SpawnageLoong/cde4301-final-report/README.md

# ASI-404: Galassia-5 Radiation Monitoring Payload Final Report

This is the final report for the Galassia-5 Radiation Monitoring Payload.

This website was built using the [Just the Docs](https://just-the-docs.com/) Jekyll theme. The theme is designed to be a simple and clean documentation theme for Jekyll.
