SpawnageLoong/cde4301-final-report/pages/4_references.md

---
title: "Appendix A: References"
nav_order: 4
permalink: /references/
---

# References

### Baraniuk, C. (2022, October 12). The computer errors from outer space. BBC. [Link](https://www.bbc.com/future/article/20221011-how-space-weather-causes-computer-errors)

### Seidleck, C. M., LaBel, K. A., Moran, A. K., Gates, M. M., Barth, J. M., Stassinopoulos, E. G., & Gruner, T. D. (n.d.). Single Event Effect Flight Data Analysis of Multiple NASA Spacecraft and Experiments; Implications to Spacecraft Electrical Designs. [Link](https://nepp.nasa.gov/docuploads/F077ADF5-6491-45DA-AE3904DA8D0C36A1/chris.pdf)

### Noeldeke, C., Boettcher, M., Mohr, U., Gaisser, S., Rua, M. A., Eickhoff, J., Leslie, M., Von Thun, M., Klinkner, S., & Varatharajoo, R. (2021). Single event upset investigations on the “Flying Laptop” satellite mission. Advances in Space Research, 67(6), 2000–2009. [Link](https://www.sciencedirect.com/science/article/pii/S0273117720309054)

### Poivey, C., Barth, J. L., LaBel, K. A., Gee, G., & Safren, H. (n.d.). In-Flight Observations of Long-Term Single- Event Effect (SEE) Performance on Orbview-2 Solid State Recorders (SSR). [Link](https://radhome.gsfc.nasa.gov/radhome/papers/nsrec03_w16.pdf)

### Olsen, W., Wood, B., & Dennison, J. (n.d.). Microcontroller Survivability in Space Conditions. [Link](https://digitalcommons.usu.edu/cgi/viewcontent.cgi?article=1406&context=researchweek)

### Matthews, M. (2021). Using bit flips as a source of randomness in cubeSat communication encryption. Acta Astronautica, 179, 546–549. [Link](https://www.sciencedirect.com/science/article/pii/S0094576520307128)

### Awati, R., & Sheldon, R. (2024, October 31). What is SRAM (static random access memory)? WhatIs. [Link](https://www.techtarget.com/whatis/definition/SRAM-static-random-access-memory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,retain%20the%20data%20in%20SRAM)

### bitsmashed. (2009, October 20). Random number generating Geiger counter. Sparkfun. Retrieved August 22, 2024, from [Link](https://www.sparkfun.com/tutorials/132)

### Gorkovenko, A. V., Sawczyn, S., Bulgakova, N. V., Jasczur-Nowicki, J., Mishchenko, V. S., & Kostyukov, A. I. (2012). Muscle agonist–antagonist interactions in an experimental joint model. Experimental Brain Research, 222(4), 399–414. [Link](https://doi.org/10.1007/s00221-012-3227-0)

### Hansen, D. L., Hillman, R., Meraz, F., Montoya, J., & Williamson, G. (n.d.). Architectural consequences of radiation performance in a flash NAND device. [Link](https://www.ddc-web.com/resources/assets/images/Articles/2017/Architectural_Consequences_of_Radiation_Performance_in_a_Flash_NAND_Device.pdf)

### Kay, M., Gadlage, M., Duncan, A., Ingalls, D., Roach, A., & NSWC Crane. (2017). Flash memory in extreme environments. In Flash Memory Summit. [Link](https://files.futurememorystorage.com/proceedings/2017/20170808_S102B_Kay.pdf)

### LND. Inc. (n.d.). 712 End Window-Alpha-Beta-Gamma Detector. LND | Nuclear Radiation Detectors. Retrieved August 13, 2024, from [Link](https://www.lndinc.com/products/geiger-mueller-tubes/712/)

### Matsusada Precision Inc. (2024). Geiger counter (Geiger-Müller tube). Matsusada Precision. Retrieved September 10, 2024, from [Link](https://www.matsusada.com/application/ps/geiger_counter/)

### NASA Science Editorial Team. (2024, September 17). Innovative Instrument Reveals Hidden Features Deep Inside the Van Allen Radiation Belts. NASA. Retrieved August 28, 2024, from [Link](https://science.nasa.gov/science-research/science-enabling-technology/technology-highlights/innovative-instrument-reveals-hidden-features-deep-inside-the-van-allen-r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)

### National Aeronautics and Space Administration. (n.d.). Outgassing Data Introduction. NASA. Retrieved October 19, 2024, from [Link](https://outgassing.nasa.gov/outgassing-data-table)

### National Aeronautics and Space Administration. (2001, September 20). NASA Parts Selection List (NPSL) - Zinc plating prohibition. NASA. Retrieved October 23, 2024, from[Link](https://nepp.nasa.gov/npsl/prohibited/zinc_prohibition.htm)

### Nuclear Power. (2024). Geiger Counter vs Ionization Chamber. Retrieved August 23, 2024, from[Link](https://www.nuclear-power.com/nuclear-engineering/radiation-detection/gaseous-ionization-detector/geiger-counter-vs-ionization-chamber/)

### Ogasawara, K., Livi, S. A., Allegrini, F., Broiles, T. W., Dayeh, M. A., Desai, M. I., Ebert, R. W., Llera, K., Vines, S. K., & McComas, D. J. (2016). Next‐generation solid‐state detectors for charged particle spectroscopy. Journal of Geophysical Research Space Physics, 121(7), 6075–6091.[Link](https://doi.org/10.1002/2016ja022559)

### S.E. International, Inc. (2019, February 14). About Radiation Detectors - Advantages & Disadvantages. Retrieved September 23, 2024, from[Link](https://seintl.com/articles/about-radiation-detectors-advantages-amp-disadvantages)

### Shah, G. (2024). Semiconductor Radiation Detector. VEDANTU. Retrieved September 23, 2024, from[Link](https://www.vedantu.com/physics/solid-state-detector)

### USC Environmental Health & Safety. (n.d.). Radiation instrumentation – USC Environmental Health & Safety. USC. Retrieved August 23, 2024, from[Link](https://ehs.usc.edu/research/rad/rad-instruments/#:~:text=Ion%20chambers%20are%20similar%20to,counting%20the%20number%20of%20pulses)

### XP Power. (2024a). AH Series Power Product Range | XP Power. Retrieved October 2, 2024, from[Link](https://www.xppower.com/product/AH-Series)

### XP Power. (2024b). DC-HVDC Converter Q Series. Retrieved October 3, 2024, from[Link](https://www.xppower.com/portals/0/pdfs/SF_Q_Series.pdf)

### XP Power. (2024c). CA Series DC-HVDC converter. Retrieved October 2, 2024, from[Link](https://www.xppower.com/portals/0/pdfs/SF_CA_Series.pdf)

### Zero Error Systems. (2022a). Single-Event Effects (SEE) Test Report of ZES100F-QFN32SP Latchup Detection and Protection (LDAP).

### Zero Error Systems. (2022b). Heavy-Ion Single-Event Effect (SEE) Test report of the ZES400-F/S-QFN28SP Quad-Channel Voter.

### Zero Error Systems. (2023a). Total Ionizing Dose (TID) Test Report of ZES100F-QFN32SP Latchup Detection and Protection (LDAP).

### Zero Error Systems. (2023b). Total Ionizing Dose (TID) Test Report of the ZES400 Quad-Channel voter.

### Zero Error Systems. (2024a). Proton Single-Event Effect (SEE) Test Report of ZSOM-M01.

### Zero Error Systems. (2024b). Radiation-Tolerant Microcontroller-Based System-on-Module (ZSOMTM-M01). In DOEEET. Retrieved August 16, 2024, from[Link](https://www.doeeet.com/home/-/catalog/document/MFR_DS_ZSOM_M01_Radiation_Tolerant_Microcontroller_Based_System_on_Module__ZSOMTM_M01__1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)

### Curbell plastics. (n.d.). Peek Plastic Material & properties | high temp, chemical resistance |[Link](https://www.curbellplastics.com/materials/plastics/peek/)

### Ensinger. (n.d.). Radiation resistant plastics.[Link](https://www.ensingerplastics.com/en-us/shapes/plastic-material-selection/radiation-resistant)

### GQ GMC-600 Plus Geiger Counter Radiation Monitor. GQ Electronics LLC True Instruments Solution. (n.d.).[Link](https://www.gqelectronicsllc.com/comersus/store/comersus_viewItem.asp?idProduct=5637)

### Howell, E. (2018, May 11). Van allen radiation belts: Facts & findings. Space.com.[Link](https://www.space.com/33948-van-allen-radiation-belts.html )

### IMS Team. (n.d.). Aluminum radiation shielding in 3D imaging - IMS. Industrial Metal Service.[Link](https://industrialmetalservice.com/metal-university/aluminum-radiation-shielding-in-3d-imaging/ )

### Julien. (n.d.). The Van Allen Belts: Are they dangerous?. Listing of all our blogs.[Link](https://blogs.esa.int/orion/2022/12/10/the-van-allen-belts-are-they-dangerous/ )

### Kelley, R. L., & Jarkey, D. R. (n.d.). CUBESAT material limits for design for demise.[Link](https://ntrs.nasa.gov/api/citations/20140016958/downloads/20140016958.pdf )

### Khozemy, E. E., Salem, E. F., & El-Hag Ali, A. (2022). Radiation shielding and enhanced thermal characteristics of high-density polyethylene reinforced with Al (OH)3/PB2O3 for Radioactive Waste Management. Radiation Physics and Chemistry, 193, 109976. [Link](https://doi.org/10.1016/j.radphyschem.2022.109976)

### NASA. (2024, August 16). What are SmallSats and CubeSats?. NASA. [Link](https://www.nasa.gov/what-are-smallsats-and-CubeSatss/)

### Ojovan, M. I., Lee, W. E., & Kalmykov, S. N. (2019b). An Introduction to Nuclear Waste Immobilisation, 53–55. [Link](https://doi.org/10.1016/c2017-0-03752-7)

### Onaizi, A. M., Amran, M., Tang, W., Betoush, N., Alhassan, M., Rashid, R. S. M., Yasin, M. F., Bayagoob, K. H., & Onaizi, S. A. (2024). Radiation-shielding concrete: A review of materials, performance, and the impact of radiation on concrete properties. Journal of Building Engineering, 97, 110800. [Link](https://doi.org/10.1016/j.jobe.2024.110800)

### Sampson, M. (n.d.). Developing a NASA lead-free policy for ... [Link](https://ntrs.nasa.gov/api/citations/20080039268/downloads/20080039268.pdf)

### George, J. S. (2019). An overview of radiation effects in electronics. [Link](https://doi.org/10.1063/1.5127719)

### De Aguiar, Y. Q., Wrobel, F., Autran, J., & Alía, R. G. (2024). Introduction to Single-Event Effects. In Springer eBooks (pp. 29–47). [Link](https://doi.org/10.1007/978-3-031-71723-9_2)

### Parris, P. (2023, December 20). Guide to Rad-hard vs. Rad-tolerant. VORAGO Technologies. Retrieved September 1, 2024, from [Link](https://www.voragotech.com/blog/rad-hard-vs-rad-tolerant)

### Taylor, D. (2023, August 10). Rad-Hard vs. Rad-Tolerant: A Guide to the Differences and Applications in Military Electronics - Military Embedded Systems. Military Embedded Systems. Retrieved September 5, 2024, from [Link](https://militaryembedded.com/comms/satellites/rad-hard-vs-rad-tolerant-a-guide-to-the-differences-and-applications-in-military-electronics)

### Lara, C. A., Fragoso, M., Juárez, L. M., Barboni, L., Reyes, R., & Vázquez, R. (2023). Fault tolerant architecture design of a CubeSat command and data handling system. IEEE Conference Publication | IEEE Xplore. [Link](https://doi.org/10.1109/LATS58125.2023.10154496)

### National Aeronautics and Space Administration. (2020). A researcher’s guide to space environmental effects. [Link](https://www.nasa.gov/wp-content/uploads/2020/10/researchers-guide-space-environment-effects_tagged.pdf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)

### NASA. (n.d.). Space faring: The radiation challenge. [Link](https://www.nasa.gov/wp-content/uploads/2009/07/284275main_Radiation_HS_Mod3.pdf) 

### Meier, M. M., Berger, T., Jahn, T., Matthiä, D., Plettenberg, M. C., Scheibinger, M., Schennetten, K., & Wirtz, M. (2023). Impact of the South Atlantic Anomaly on radiation exposure at flight altitudes during solar minimum. Scientific Reports, 13(1). [Link](https://doi.org/10.1038/s41598-023-36190-5)
