SpawnageLoong/cde4301-final-report/pages/2_individuals/1_index.md

---
title: Individual Contributions
nav_order: 2
permalink: /individuals/
has_toc: false
---

<h1>Team Members</h1>

<div style="margin-top:2em ;display:flex; flex-wrap:wrap; gap:32px">
  <div style="width:150px">
    <a href="{{site.baseurl}}/wei-hao">
      Wei Hao
      <h2>Wei Hao</h2>
      <p>A0240152X<br>Electrical</p>
    </a>
  </div>
  <div style="width:150px">
    <a href="{{site.baseurl}}/sowmya">
      Sowmya
      <h2>Sowmya</h2>
      <p>A0246190H<br>Electrical</p>
    </a>
  </div>
  <div style="width:150px">
    <a href="{{site.baseurl}}/richard">
      Richard
      <h2>Richard</h2>
      <p>A0233496X<br>Software</p>
    </a>
  </div>
  <div style="width:150px">
    <a href="{{site.baseurl}}/ming-chuan">
      Ming Chuan
      <h2>Ming Chuan</h2>
      <p>A0240129N<br>Mechanical</p>
    </a>
  </div>
</div>
