SpawnageLoong/cde4301-final-report/pages/5_individuals/1_index.md

---
title: Individual Contributions
nav_order: 5
permalink: /individuals/
---

<div style="display:flex; flex-wrap:wrap; gap:32px">
  <div style="width:150px">
    <a href="{{site.baseurl}}/wei-hao">
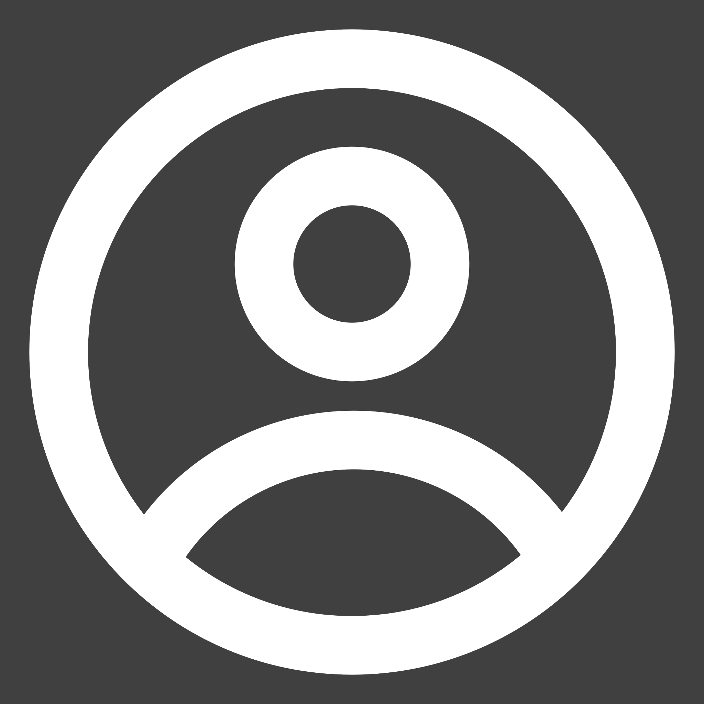
[picture p146: assets/images/profiles/weihao.png]
Wei Hao
      
      <h2>Wei Hao</h2>
      <p>Lorem ipsum blah blah blah</p>
    </a>
  </div>
  <div style="width:150px">
    <a href="{{site.baseurl}}/sowmya">
      Sowmya
      <h2>Sowmya</h2>
      <p>Lorem ipsum blah blah blah</p>
    </a>
  </div>
  <div style="width:150px">
    <a href="{{site.baseurl}}/richard">
      Richard
      <h2>Richard</h2>
      <p>Lorem ipsum blah blah blah</p>
    </a>
  </div>
  <div style="width:150px">
    <a href="{{site.baseurl}}/sarah">
      Ming Chuan
      <h2>Ming Chuan</h2>
      <p>Lorem ipsum blah blah blah</p>
    </a>
  </div>
</div>
