SpawnageLoong/cde4301-final-report/assets/images/appendix_b/B2/table 1.png

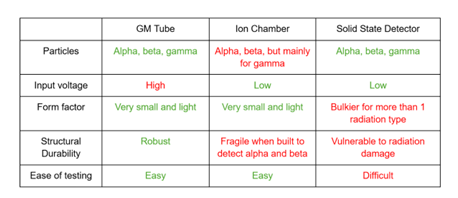
assets/images/appendix_b/B2/table 1.png
