SpawnageLoong/cde4301-final-report/assets/images/appendix_b/B4/fig 3.jpg

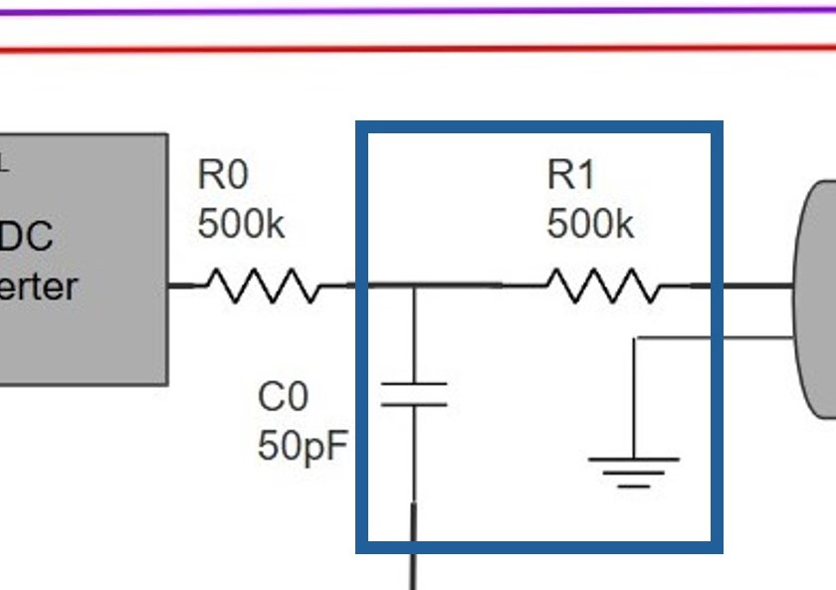
assets/images/appendix_b/B4/fig 3.jpg
