SpawnageLoong/cde4301-final-report/assets/images/mingchuan/img_1.png

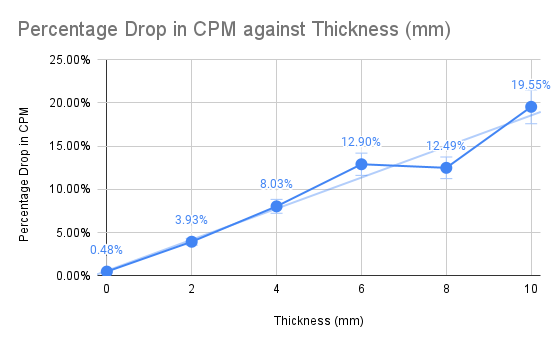
assets/images/mingchuan/img_1.png
