SpawnageLoong/cde4301-final-report/assets/images/mingchuan/img_2.png

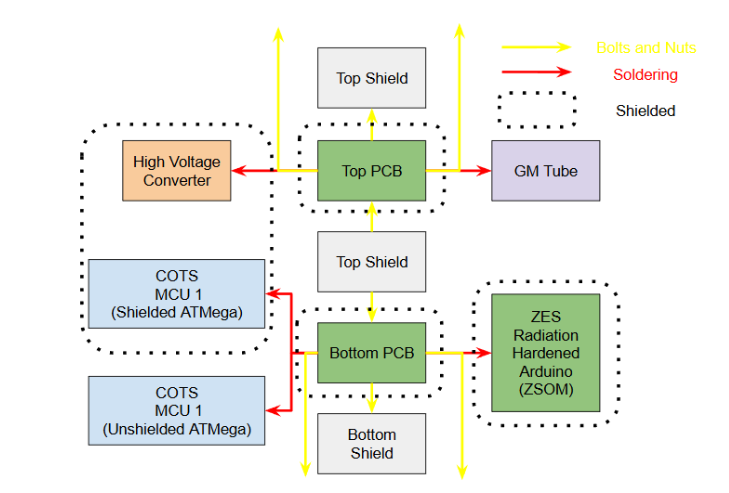
assets/images/mingchuan/img_2.png
