SpawnageLoong/cde4301-final-report/assets/images/mingchuan/img_3.png

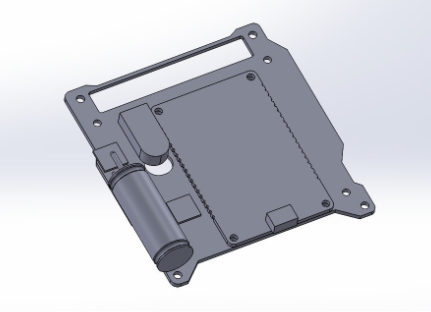
assets/images/mingchuan/img_3.png
