SpawnageLoong/cde4301-final-report/assets/images/mingchuan/img_4.png

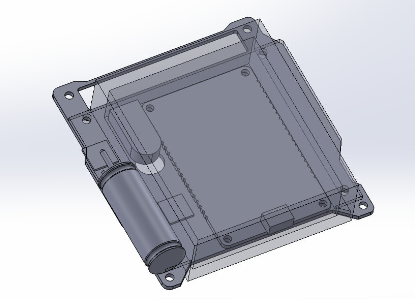
assets/images/mingchuan/img_4.png
