SpawnageLoong/cde4301-final-report/assets/images/mingchuan/img_5.png

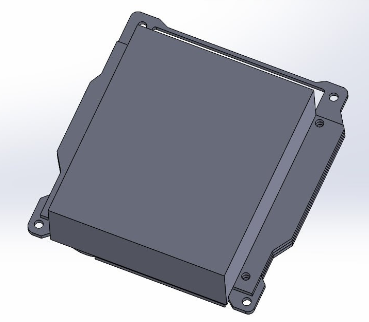
assets/images/mingchuan/img_5.png
