SpawnageLoong/cde4301-final-report/assets/images/mingchuan/img_6.png

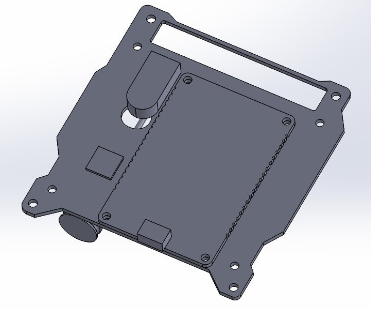
assets/images/mingchuan/img_6.png
