SpawnageLoong/cde4301-final-report/assets/images/mingchuan/img_7.png

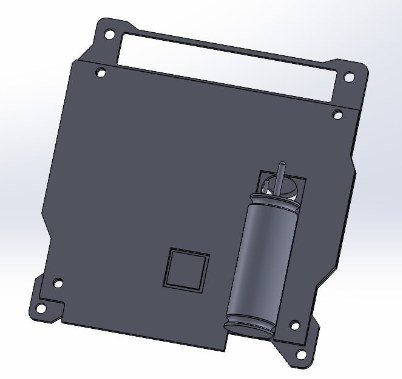
assets/images/mingchuan/img_7.png
