SpawnageLoong/cde4301-final-report/assets/images/mingchuan/img_8.png

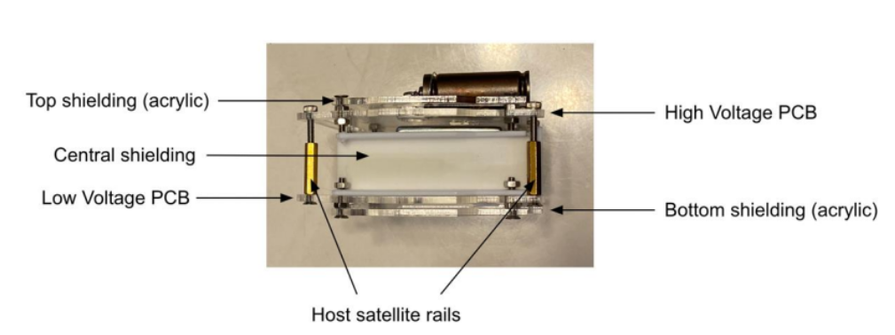
assets/images/mingchuan/img_8.png
