SpawnageLoong/cde4301-final-report/assets/images/mingchuan/img_9.png

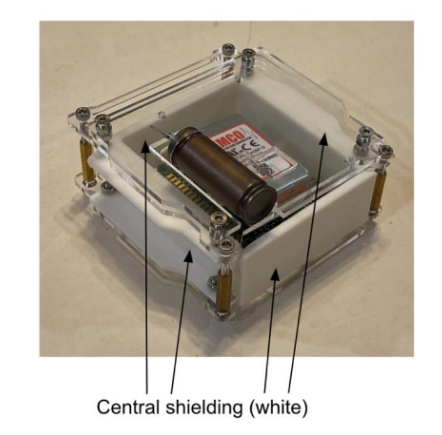
assets/images/mingchuan/img_9.png
