SpawnageLoong/cde4301-final-report/assets/images/richard/IMG_2598.jpg

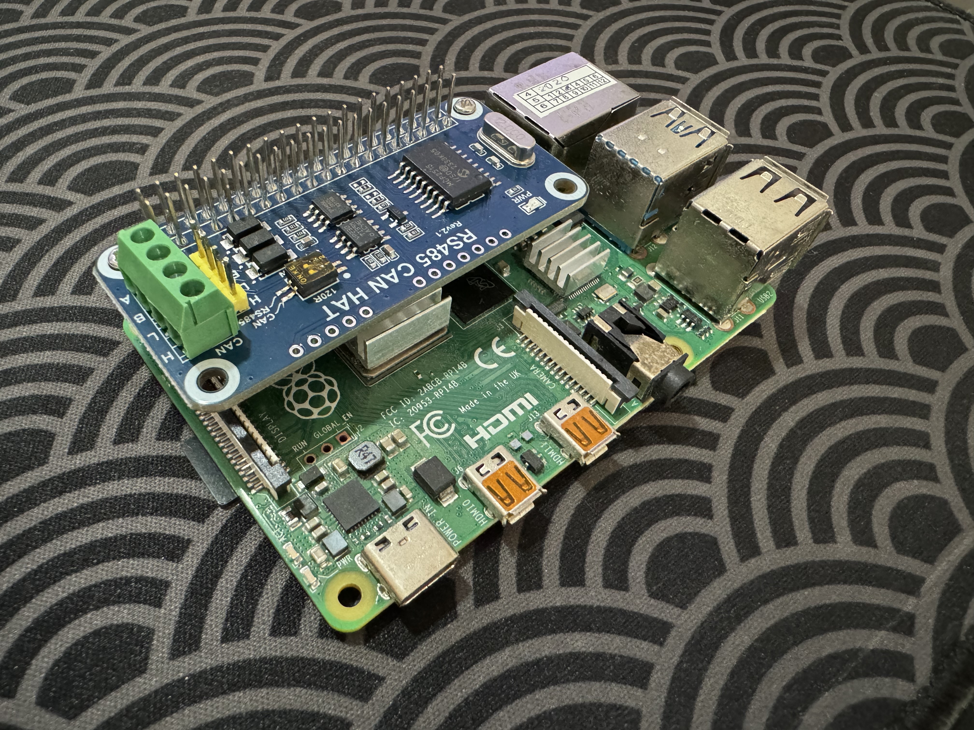
assets/images/richard/IMG_2598.jpg
