SpawnageLoong/cde4301-final-report/assets/images/richard/pc104 connector.png

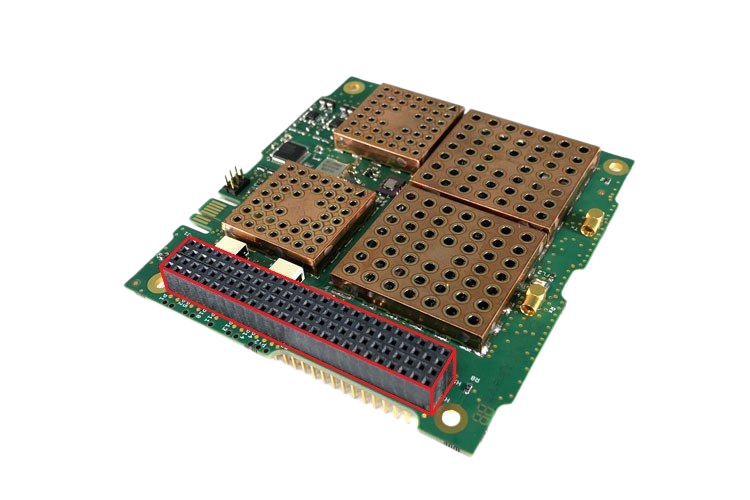
assets/images/richard/pc104 connector.png
