SpawnageLoong/cde4301-final-report/assets/images/sowmya/Fig3.1.jpg

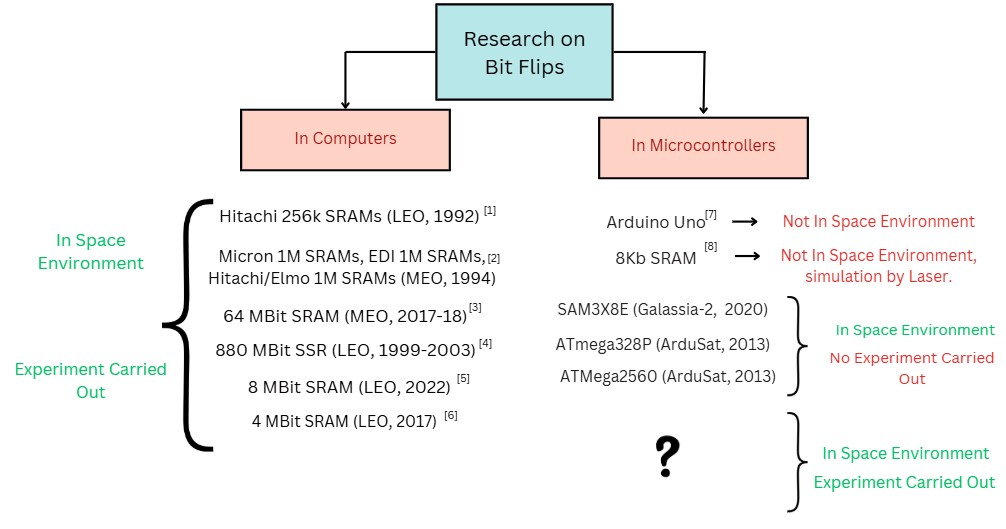
assets/images/sowmya/Fig3.1.jpg
