SpawnageLoong/cde4301-final-report/assets/images/richard/data_frame_test.png

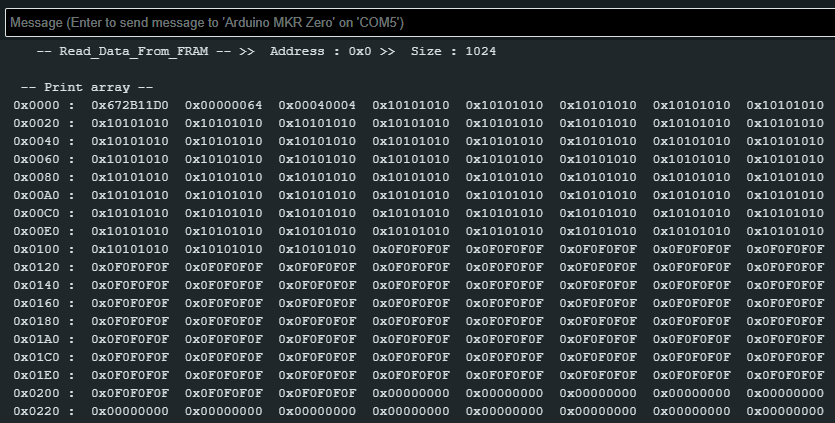
assets/images/richard/data_frame_test.png
