SpawnageLoong/cde4301-final-report/assets/files/sowmya/FYP_Schematic_PDF.pdf

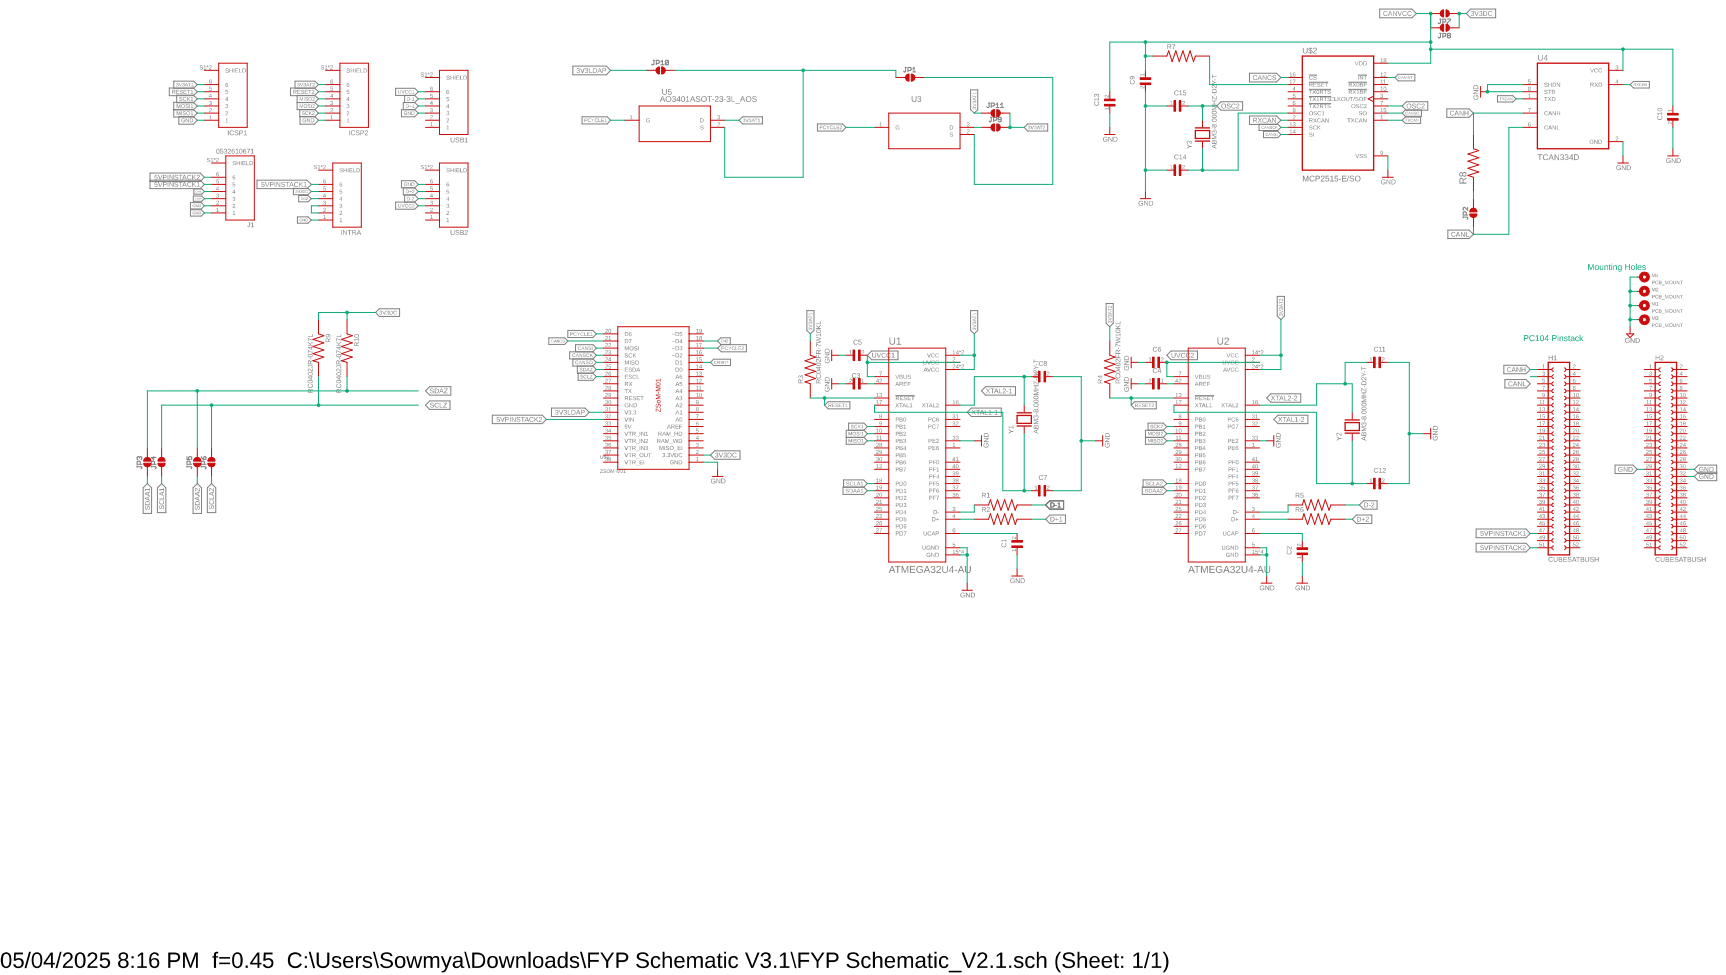
[picture p162: page 1]
