SpawnageLoong/cde4301-final-report/assets/files/weihao/Fig16.pdf

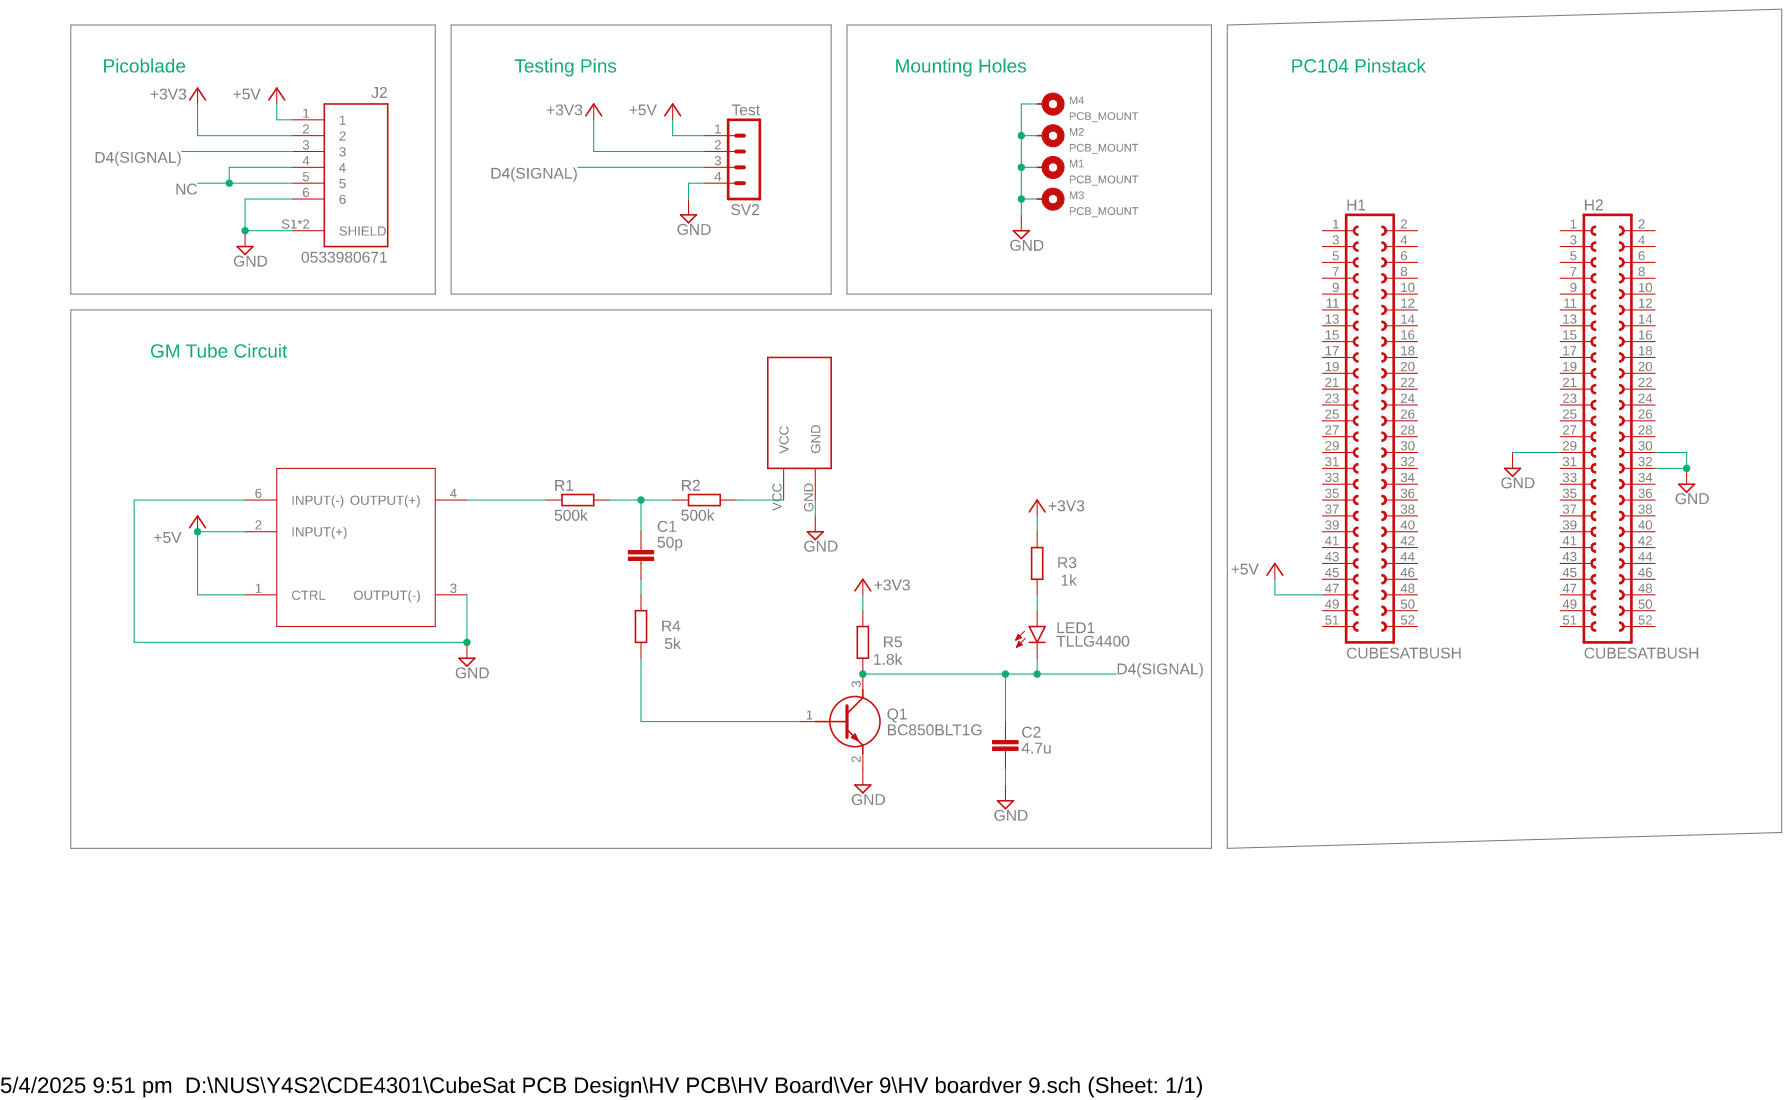
[picture p163: page 1]
