SpawnageLoong/cde4301-final-report/assets/files/sowmya/FYP_Board_pdf.pdf

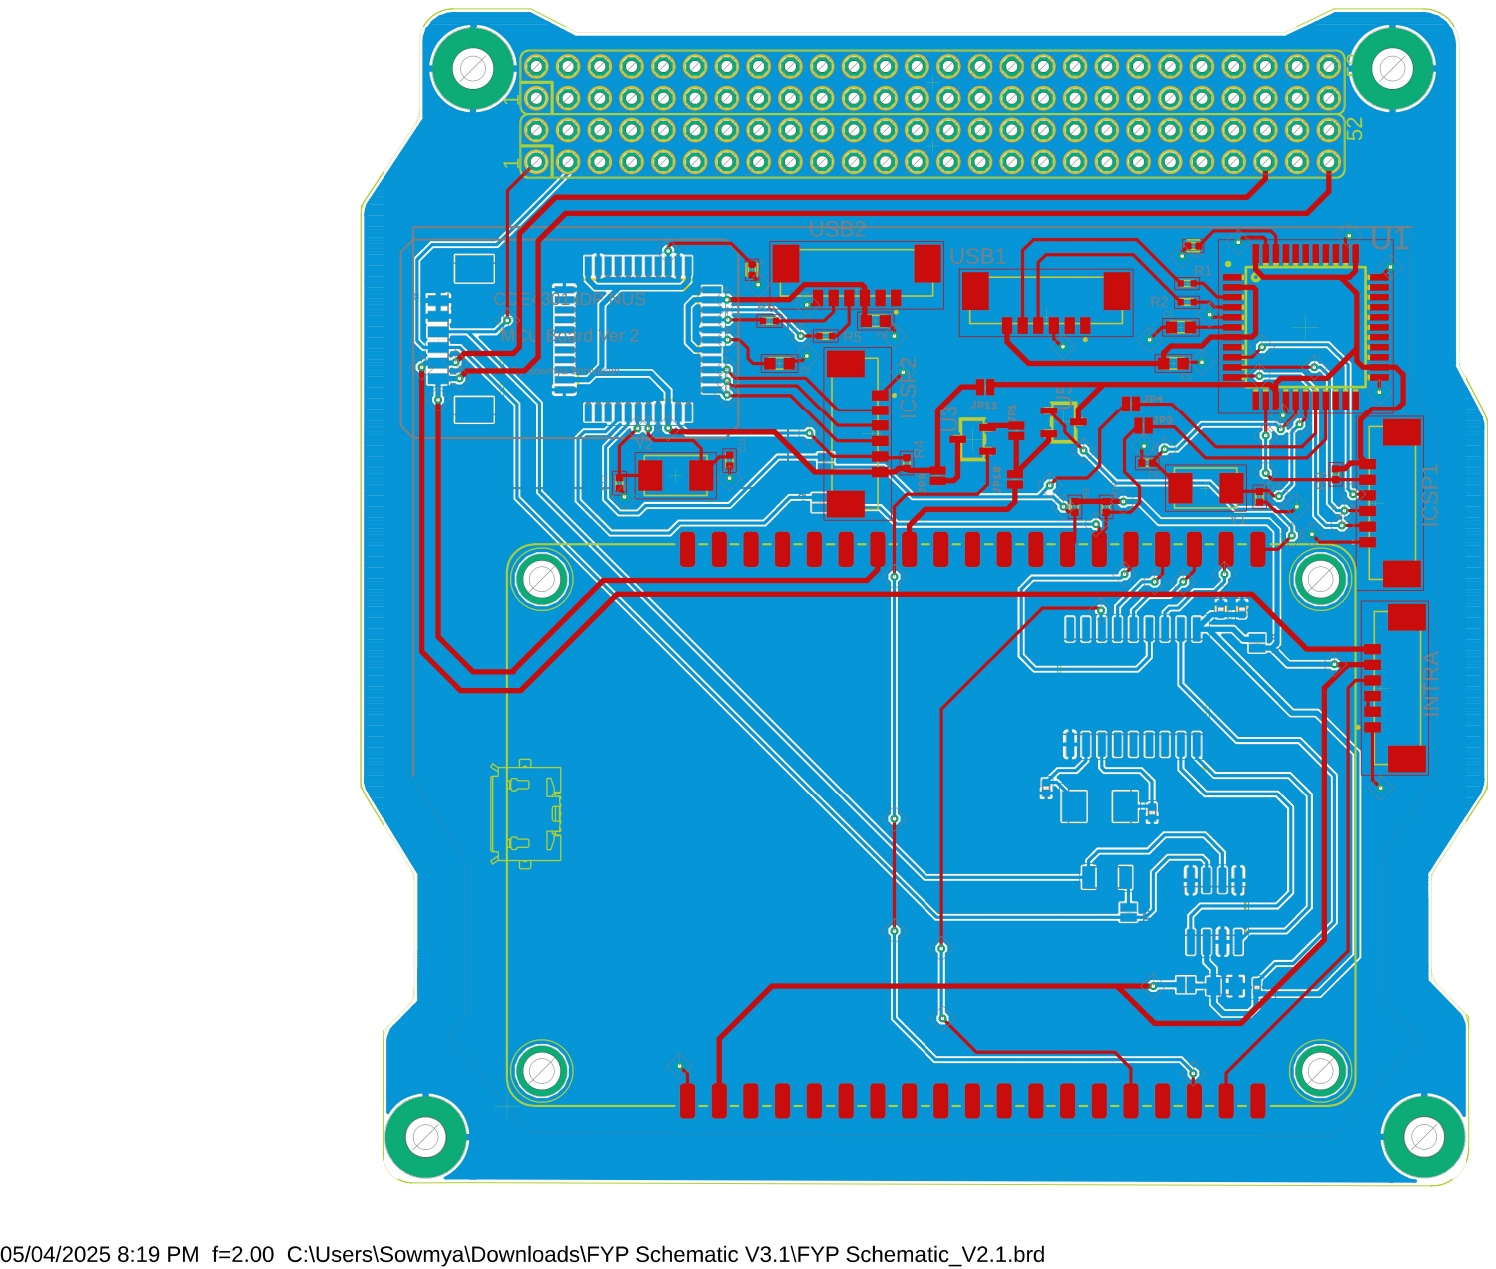
[picture p164: page 1]
