SpawnageLoong/cde4301-final-report/(commit log)

2024-11-16 Add table titles, modified one table
    The table in the data collection and verification section of the prototype were changed to the correct versions. Table and figure titles for all were added.
2025-04-05 Replaced PCB images
2025-04-15 Edit sensor
